Cristina-ARod/P-ndulo-invertido/README.md

# P-ndulo-invertido
Péndulo invertido para Teoría de contol
